claytonyen/electra-distortion-pedal/asc files/Electra_1.asc

C1: cap; 470n
C2: cap; 22p
C3: cap; 100n
D1: diode; 1N4148
D2: diode; 1N4148
D3: diode; 1N4148
Q1: npn; 2N3904
R1: res; 470R
R2: res; 10.2k
R3: res; 3.3Meg
V1: voltage; 9V
V2: voltage; SINE(0 1.5 110)
Named nets: Vs, 0, Vin, Vout
.tran 0 0.1 0
