claytonyen/electra-distortion-pedal/asc files/Electra_2.asc

C1: cap; 470n
C2: cap; 22p
C3: cap; 100n
D2: diode; 1N270
D3: diode; 1N5819
Q1: npn; 2N3904
R1: res; 470R
R2: res; 10.2k
R3: res; 3.3Meg
V1: voltage; 9V
V2: voltage; SINE(0 1.5 110)
Named nets: Vs, 0, Vin, Vout
.tran 0 0.1 0
.model 1N270 D(Is=200n Rs=7 N=1.3 Cjo=0.5p M=0.27 Eg=0.67 Bv=75 Ibv=18m)
