claytonyen/electra-distortion-pedal/(commit log)

2026-07-10 Enhance README with circuit details and modifications
    Expanded the README with details about the electra distortion pedal circuit, including design choices and modifications made to the original schematic.
2026-07-14 Revise diode clipping stage details in README
    Updated diode types and configurations in the distortion circuit description. Added details about the second attempt with new diodes and their effects on signal clipping.
2026-07-14 Enhance README with diode behavior details
    Added explanation about diode behavior and its effect on signal processing.
